damienmaguire/Tesla-Model-3-Charger/DSC_0032_s.jpg

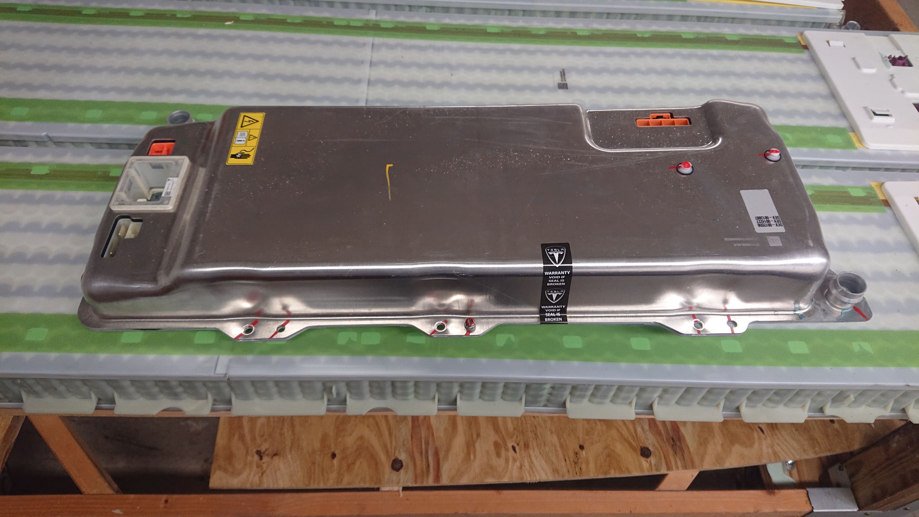
DSC_0032_s.jpg
