damienmaguire/Tesla-Model-3-Charger/Software/stm32-M3-PCS/README.md

# Tesla Model 3 PCS Controller Firmware
02/09/22: V1 of new firmware for STM32 based Tesla Model 3 PCS Controller.

# Compiling
You will need the arm-none-eabi toolchain: https://developer.arm.com/open-source/gnu-toolchain/gnu-rm/downloads
On Ubuntu type

`sudo apt-get install git gcc-arm-none-eabi`

The only external depedencies are libopencm3 and libopeninv. You can download and build these dependencies by typing

`make get-deps`

Now you can compile stm32-<yourname> by typing

`make`

And upload it to your board using a JTAG/SWD adapter, the updater.py script or the esp8266 web interface.
