damienmaguire/Tesla-Model-3-Charger/(threads)

Thread 3 (2023-01-24):

V3 AMPseal 32 way connector locator pins misaligned on the board

joekitch, 2023-01-24:
Documented in this thread on the openinverter forums
https://openinverter.org/forum/viewtopic.php?p=51887#p51887

It looks like the two holes which the ampseal connectors uses to clip onto the board, before soldering, are misaligned. One side seems to be in the correct location but the other is too far out.
