damienmaguire/Tesla-Model-3-Charger/Controller/M3_PCSController_V1 - Schematic.pdf

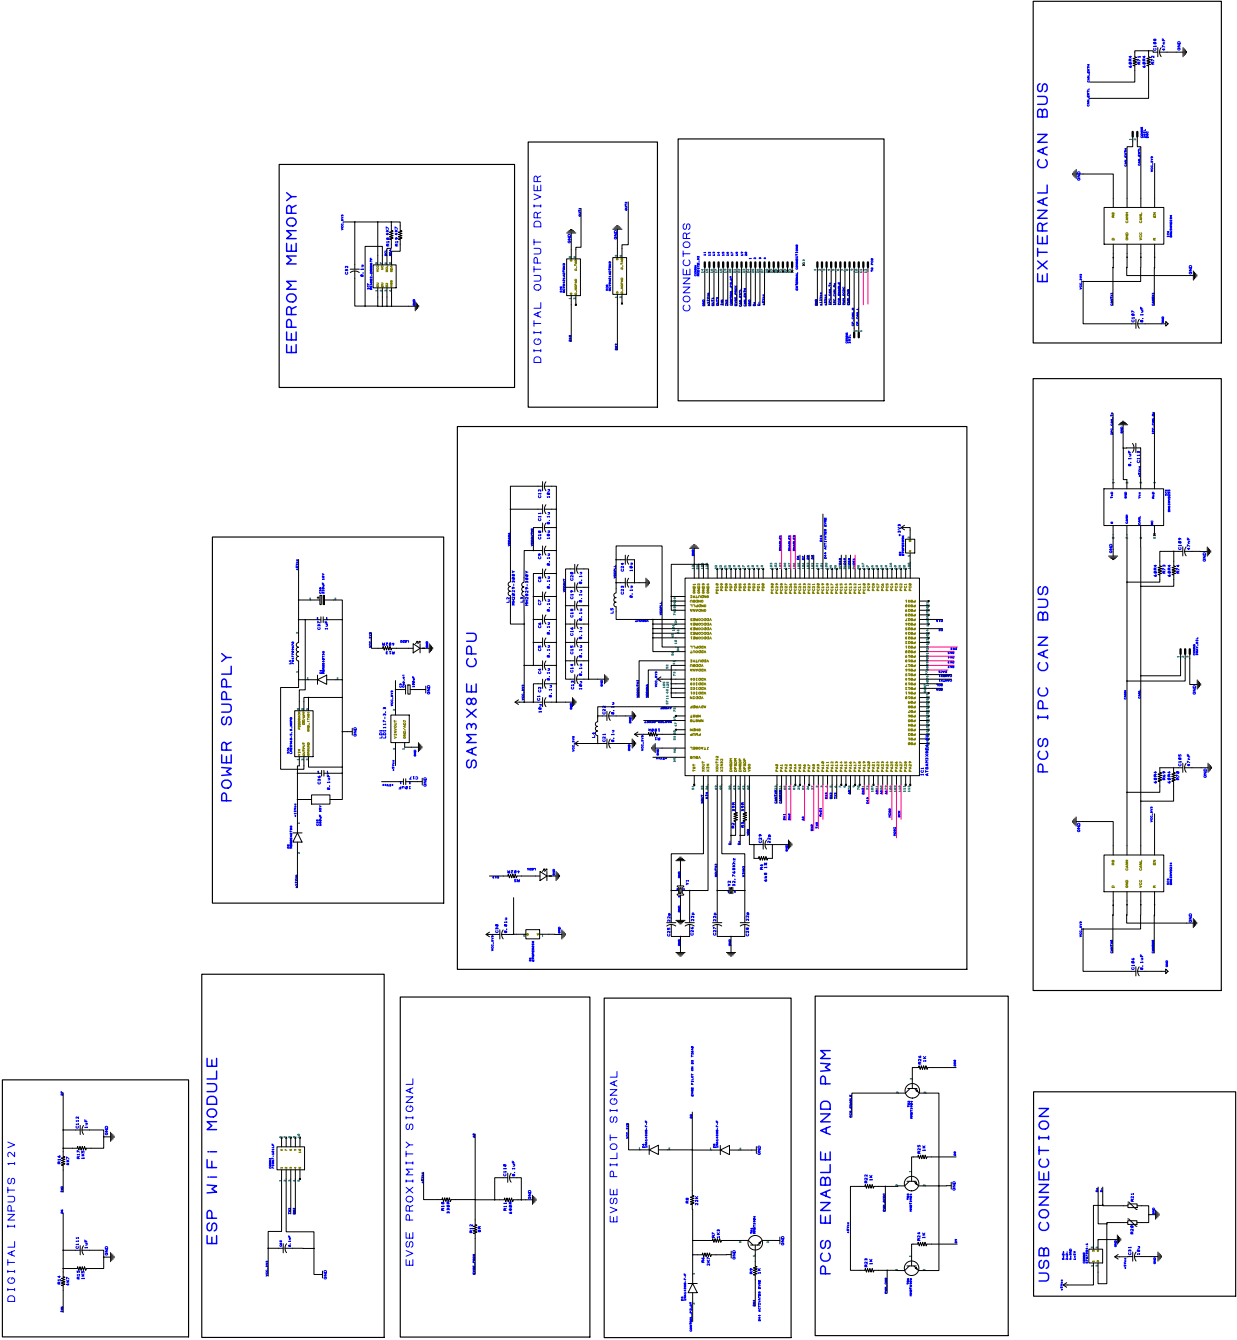
[picture p2: page 1]
