damienmaguire/Tesla-Model-3-Charger/Controller/V3/M3_PCSController_V3 - Schematic.pdf

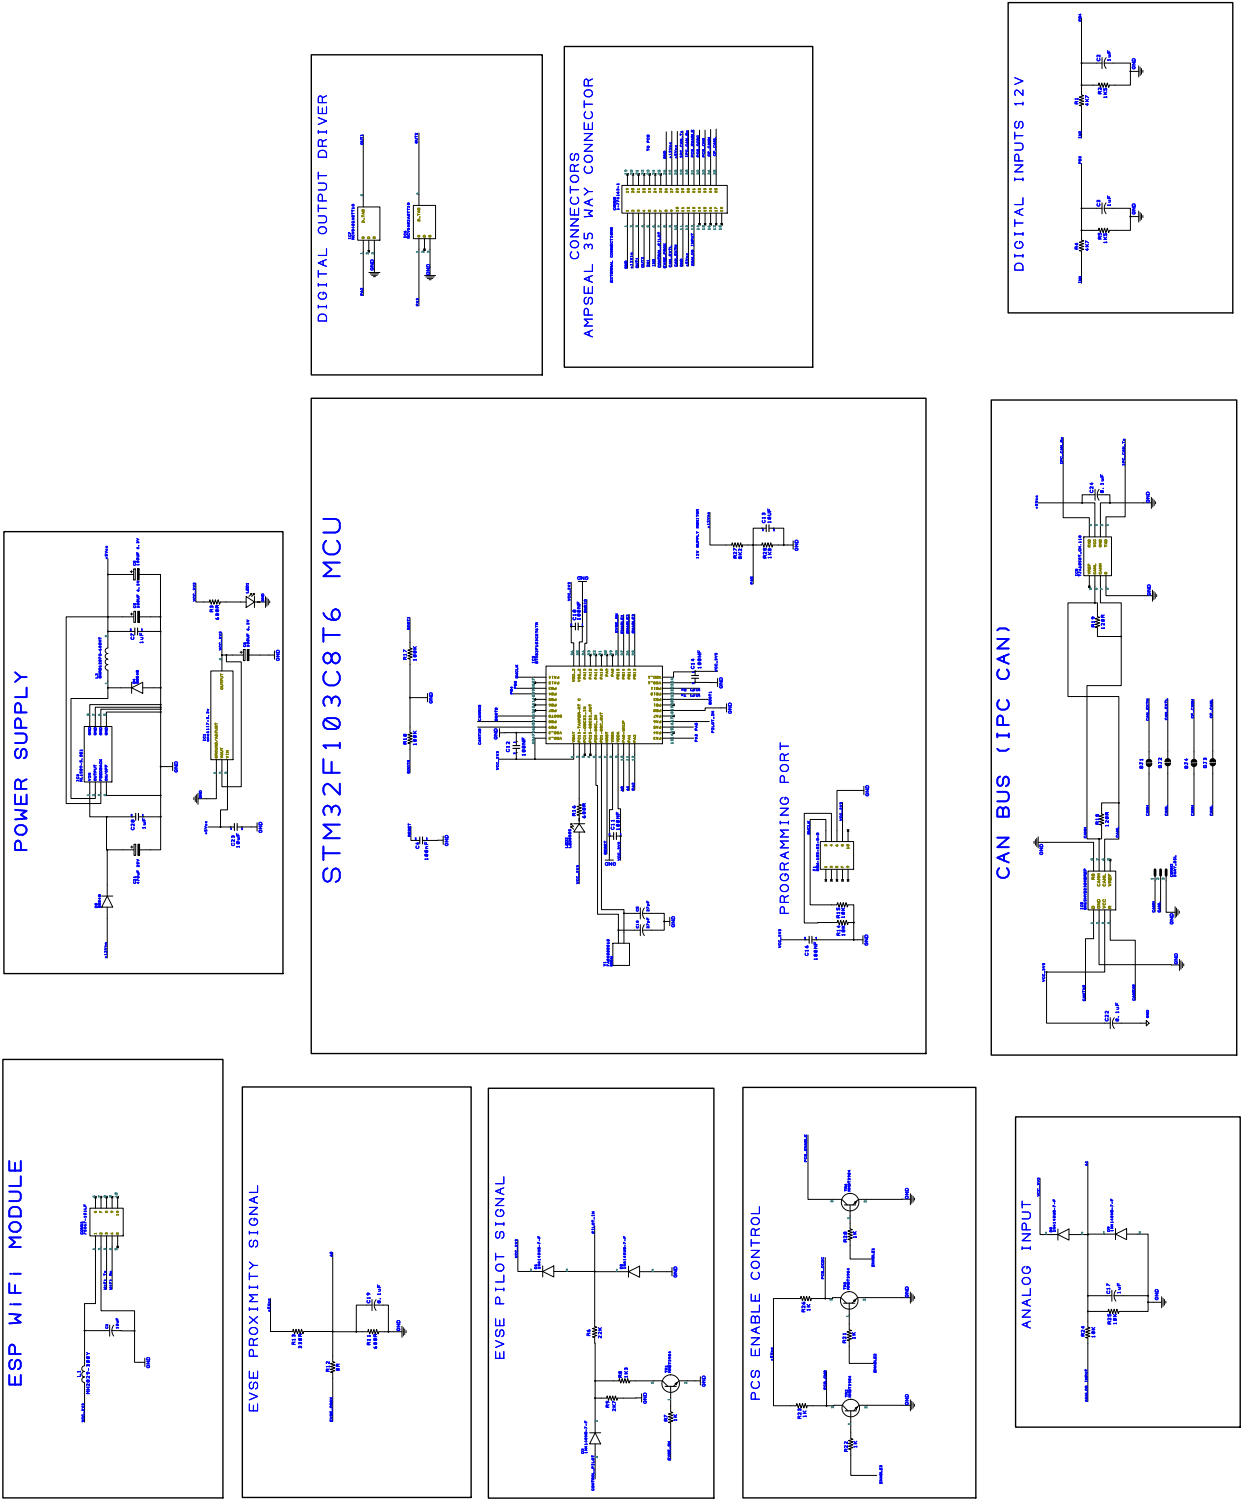
[picture p3: page 1]
