damienmaguire/Tesla-Model-3-Charger/Controller/M3_PCSController_V1 - PCB.pdf

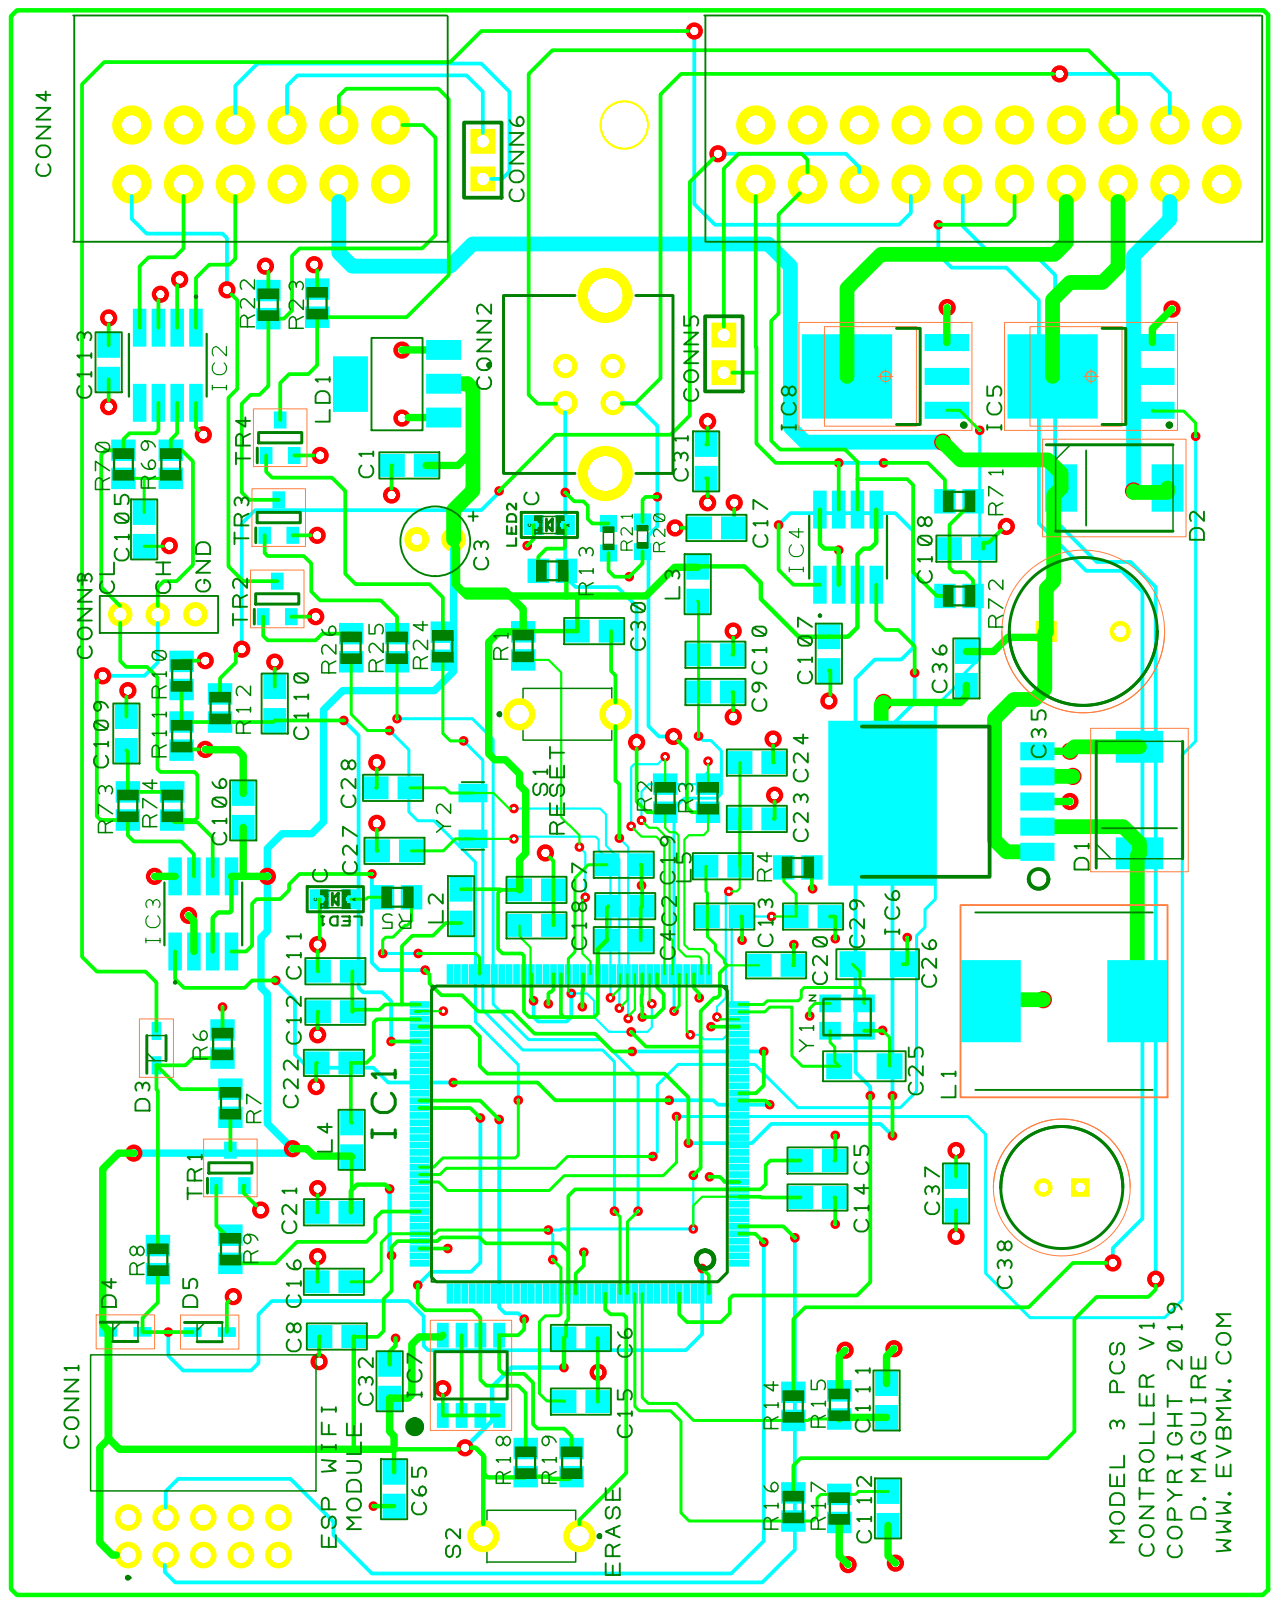
[picture p4: page 1]
