damienmaguire/Tesla-Model-3-Charger/Controller/V3/M3_PCSController_V3 - PCB.pdf

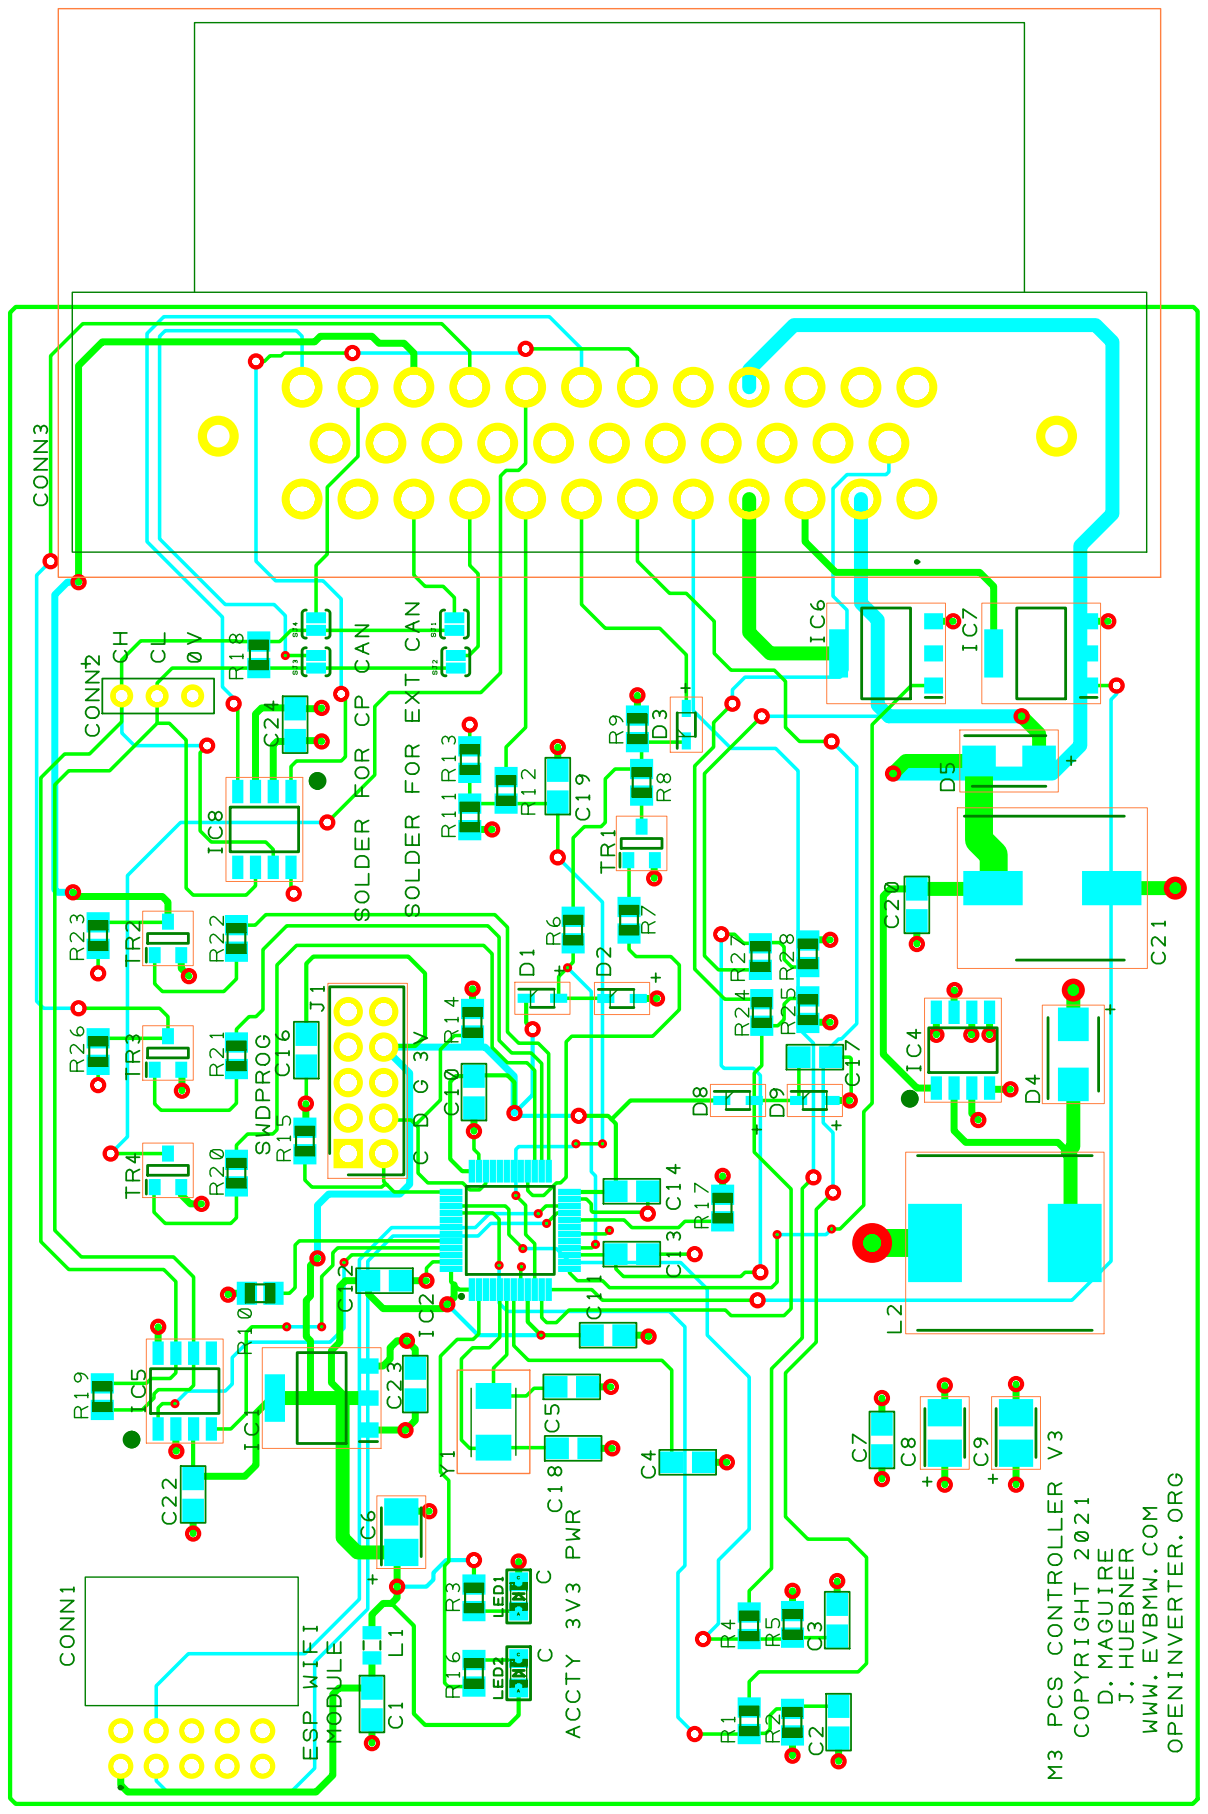
[picture p5: page 1]
