damienmaguire/Tesla-Model-3-Charger/Controller/V2/M3_PCSController_V2 - Schematic.pdf

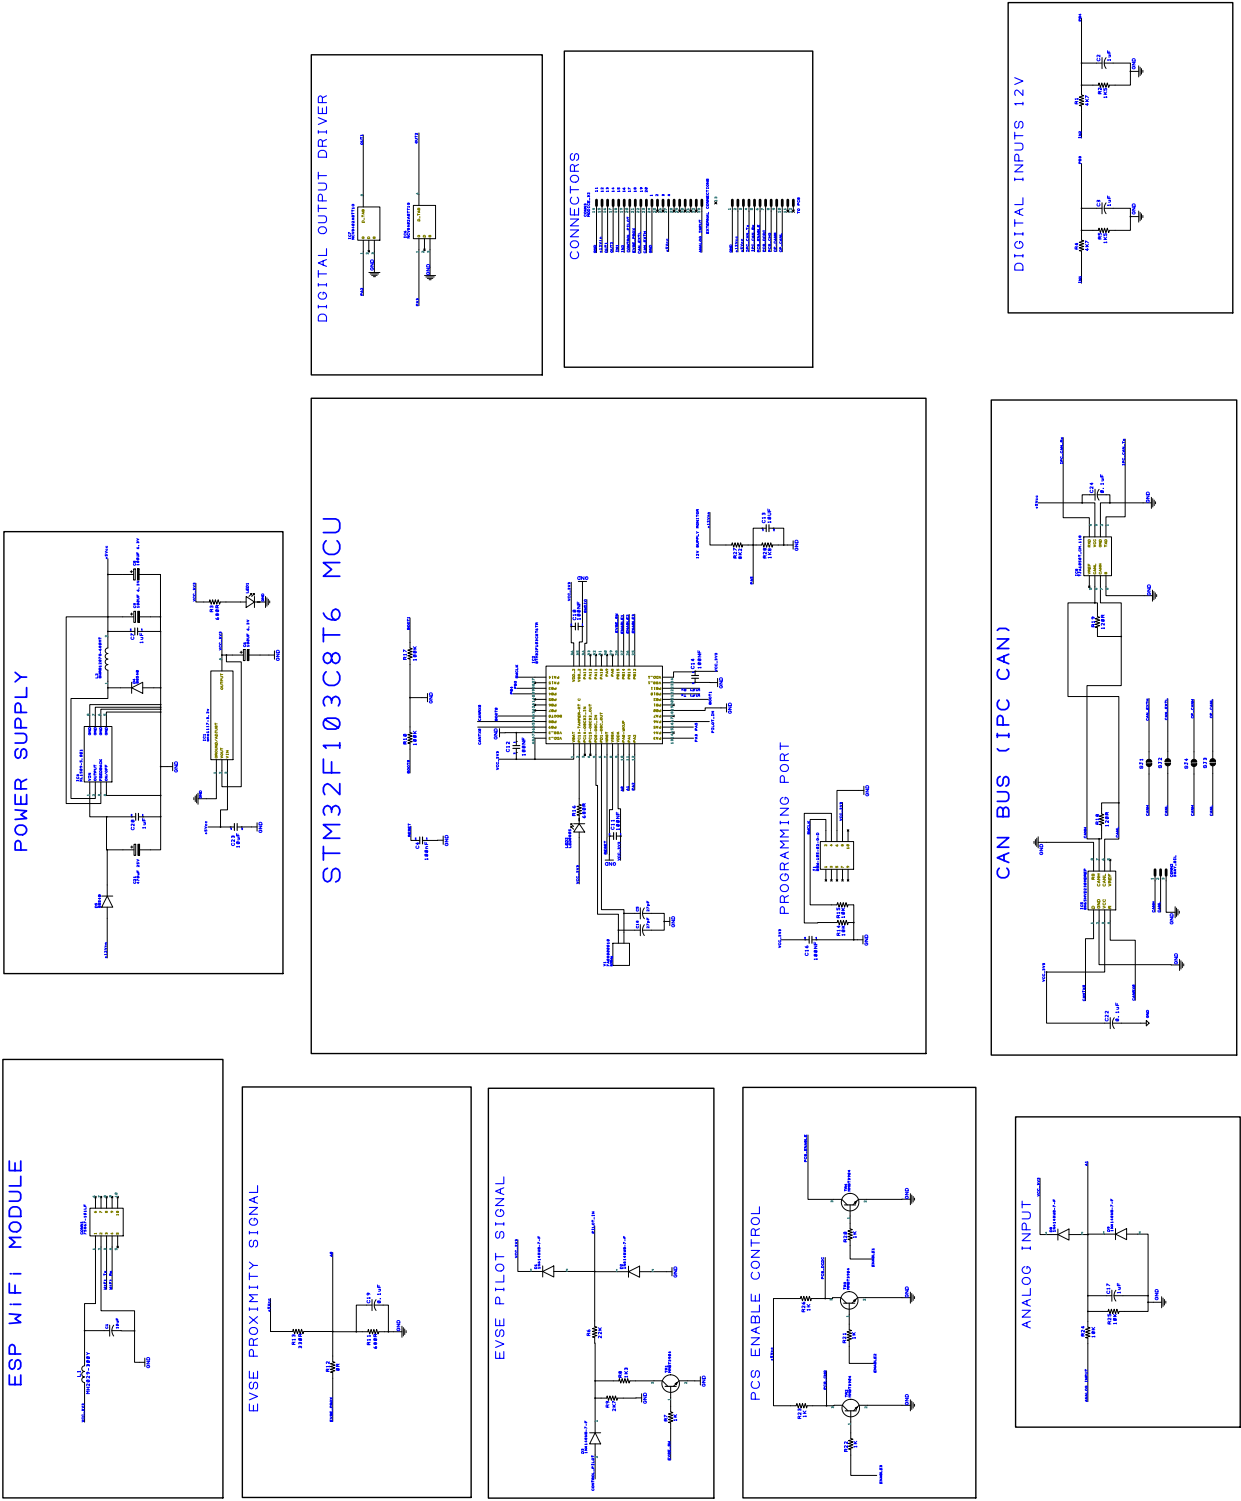
[picture p6: page 1]
