damienmaguire/Tesla-Model-3-Charger/Controller/V2/M3_PCSController_V2 - PCB.pdf

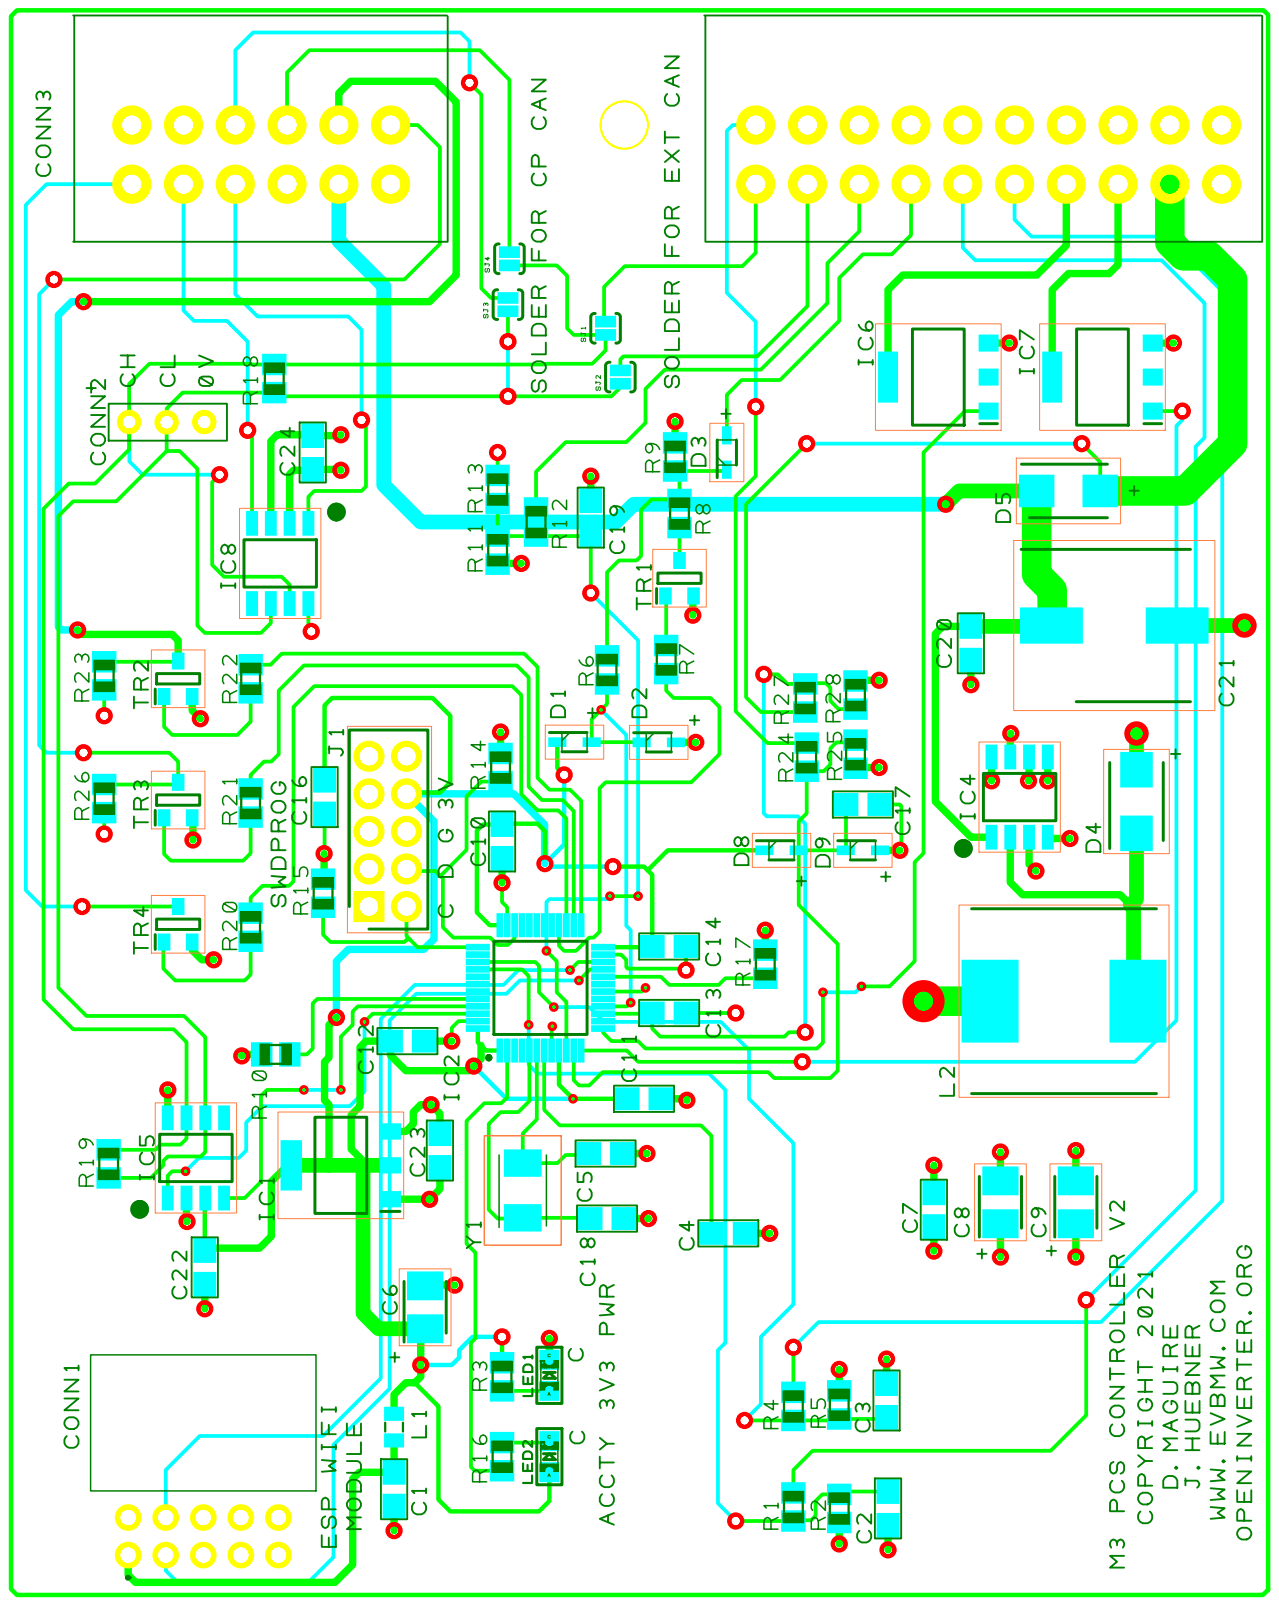
[picture p7: page 1]
