damienmaguire/Tesla-Model-3-Charger/(list of files, drawings)

Other design files:
Controller/M3_PCSController_V1.pcb
