damienmaguire/Tesla-Model-3-Charger/Software/stm32-M3-PCS/src/stm32_can.cpp

/*
 * This file is part of the libopeninv project.
 *
 * Copyright (C) 2016 Nail Güzel
 * Johannes Huebner <dev@johanneshuebner.com>
 *
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
 * You should have received a copy of the GNU General Public License
 * along with this program.  If not, see <http://www.gnu.org/licenses/>.
 */
#include <stdint.h>
#include "hwdefs.h"
#include "my_string.h"
#include "my_math.h"
#include "printf.h"
#include <libopencm3/stm32/can.h>
#include <libopencm3/stm32/gpio.h>
#include <libopencm3/stm32/rcc.h>
#include <libopencm3/stm32/flash.h>
#include <libopencm3/stm32/crc.h>
#include <libopencm3/stm32/rtc.h>
#include <libopencm3/stm32/desig.h>
#include <libopencm3/cm3/common.h>
#include <libopencm3/cm3/nvic.h>
#include "stm32_can.h"

#define MAX_INTERFACES        2
#define IDS_PER_BANK          4
#define EXT_IDS_PER_BANK      2
#define SDO_WRITE             0x40
#define SDO_READ              0x22
#define SDO_ABORT             0x80
#define SDO_WRITE_REPLY       0x23
#define SDO_READ_REPLY        0x43
#define SDO_ERR_INVIDX        0x06020000
#define SDO_ERR_RANGE         0x06090030
#define SENDMAP_ADDRESS(b)    b
#define RECVMAP_ADDRESS(b)    (b + sizeof(canSendMap))
#define POSMAP_ADDRESS(b)     (b + sizeof(canSendMap) + sizeof(canRecvMap))
#define CRC_ADDRESS(b)        (b + sizeof(canSendMap) + sizeof(canRecvMap) + sizeof(canPosMap))
#define SENDMAP_WORDS         (sizeof(canSendMap) / (sizeof(uint32_t)))
#define RECVMAP_WORDS         (sizeof(canRecvMap) / (sizeof(uint32_t)))
#define POSMAP_WORDS          ((sizeof(CANPOS) * MAX_ITEMS) / (sizeof(uint32_t)))
#define ITEM_UNSET            0xff
#define forEachCanMap(c,m) for (CANIDMAP *c = m; (c - m) < MAX_MESSAGES && c->first != MAX_ITEMS; c++)
#define forEachPosMap(c,m) for (CANPOS *c = &canPosMap[m->first]; c->next != ITEM_UNSET; c = &canPosMap[c->next])

#ifdef CAN_EXT
#define IDMAPSIZE 8
#else
#define IDMAPSIZE 4
#endif // CAN_EXT
#if (MAX_ITEMS * 12 + 2 * MAX_MESSAGES * IDMAPSIZE + 4) > FLASH_PAGE_SIZE
#error CANMAP will not fit in one flash page
#endif

struct CAN_SDO
{
   uint8_t cmd;
   uint16_t index;
   uint8_t subIndex;
   uint32_t data;
} __attribute__((packed));

struct CANSPEED
{
   uint32_t ts1;
   uint32_t ts2;
   uint32_t prescaler;
};

Can* Can::interfaces[MAX_INTERFACES];
volatile bool Can::isSaving = false;

static void DummyCallback(uint32_t i, uint32_t* d) { i=i; d=d; }
static const CANSPEED canSpeed[Can::BaudLast] =
{
   { CAN_BTR_TS1_9TQ, CAN_BTR_TS2_6TQ, 18}, //125kbps
   { CAN_BTR_TS1_9TQ, CAN_BTR_TS2_6TQ, 9 }, //250kbps
   { CAN_BTR_TS1_4TQ, CAN_BTR_TS2_3TQ, 9 }, //500kbps
   { CAN_BTR_TS1_5TQ, CAN_BTR_TS2_3TQ, 5 }, //800kbps
   { CAN_BTR_TS1_6TQ, CAN_BTR_TS2_5TQ, 3 }, //1000kbps
};

/** \brief Add periodic CAN message
 *
 * \param param Parameter index of parameter to be sent
 * \param canId CAN identifier of generated message
 * \param offset bit offset within the 64 message bits
 * \param length number of bits
 * \param gain Fixed point gain to be multiplied before sending
 * \return success: number of active messages
 * Fault:
 * - CAN_ERR_INVALID_ID ID was > 0x1fffffff
 * - CAN_ERR_INVALID_OFS Offset > 63
 * - CAN_ERR_INVALID_LEN Length > 32
 * - CAN_ERR_MAXMESSAGES Already 10 send messages defined
 * - CAN_ERR_MAXITEMS Already than MAX_ITEMS items total defined
 */
int Can::AddSend(Param::PARAM_NUM param, uint32_t canId, uint8_t offsetBits, uint8_t length, float gain, int8_t offset)
{
   return Add(canSendMap, param, canId, offsetBits, length, gain, offset);
}

int Can::AddSend(Param::PARAM_NUM param, uint32_t canId, uint8_t offsetBits, uint8_t length, float gain)
{
   return Add(canSendMap, param, canId, offsetBits, length, gain, 0);
}

/** \brief Map data from CAN bus to parameter
 *
 * \param param Parameter index of parameter to be received
 * \param canId CAN identifier of consumed message
 * \param offset bit offset within the 64 message bits
 * \param length number of bits
 * \param gain Fixed point gain to be multiplied after receiving
 * \return success: number of active messages
 * Fault:
 * - CAN_ERR_INVALID_ID ID was > 0x1fffffff
 * - CAN_ERR_INVALID_OFS Offset > 63
 * - CAN_ERR_INVALID_LEN Length > 32
 * - CAN_ERR_MAXMESSAGES Already 10 receive messages defined
 * - CAN_ERR_MAXITEMS Already than MAX_ITEMS items total defined
 */
int Can::AddRecv(Param::PARAM_NUM param, uint32_t canId, uint8_t offsetBits, uint8_t length, float gain, int8_t offset)
{
   int res = Add(canRecvMap, param, canId, offsetBits, length, gain, offset);
   ConfigureFilters();
   return res;
}

int Can::AddRecv(Param::PARAM_NUM param, uint32_t canId, uint8_t offsetBits, uint8_t length, float gain)
{
   return Can::AddRecv(param, canId, offsetBits, length, gain, 0);
}

/** \brief Set function to be called for user handled CAN messages
 *
 * \param recv Function pointer to void func(uint32_t, uint32_t[2]) - ID, Data
 */
void Can::SetReceiveCallback(void (*recv)(uint32_t, uint32_t*))
{
   recvCallback = recv;
}

/** \brief Add CAN Id to user message list
 * \post Receive callback will be called when a message with this Id id received
 * \param canId CAN identifier of message to be user handled
 * \return true: success, false: already 10 messages registered
 *
 */
bool Can::RegisterUserMessage(uint32_t canId)
{
   if (nextUserMessageIndex < MAX_USER_MESSAGES)
   {
      userIds[nextUserMessageIndex] = canId;
      nextUserMessageIndex++;
      ConfigureFilters();
      return true;
   }
   return false;
}

/** \brief Remove all CAN Id from user message list
 */
void Can::ClearUserMessages()
{
   nextUserMessageIndex = 0;
   ConfigureFilters();
}

/** \brief Find first occurence of parameter in CAN map and output its mapping info
 *
 * Memory layout: SendMap, RecvMap, PosMap, CRC
 * Send/Recv maps point to items in PosMap. PosMap may point to next item
 *
 * \param[in] param Index of parameter to be looked up
 * \param[out] canId CAN identifier that the parameter is mapped to
 * \param[out] offset bit offset that the parameter is mapped to
 * \param[out] length number of bits that the parameter is mapped to
 * \param[out] gain Parameter gain
 * \param[out] rx true: Parameter is received via CAN, false: sent via CAN
 * \return true: parameter is mapped, false: not mapped
 */
bool Can::FindMap(Param::PARAM_NUM param, uint32_t& canId, uint8_t& offset, uint8_t& length, float& gain, bool& rx)
{
   rx = false;
   bool done = false;

   for (CANIDMAP *map = canSendMap; !done; map = canRecvMap)
   {
      forEachCanMap(curMap, map)
      {
         forEachPosMap(curPos, curMap)
         {
            if (curPos->mapParam == param)
            {
               canId = curMap->canId;
               offset = curPos->offsetBits;
               length = curPos->numBits;
               gain = curPos->gain;
               return true;
            }
         }
      }
      done = rx;
      rx = true;
   }
   return false;
}

/** \brief Save CAN mapping to flash
 */
void Can::Save()
{
   uint32_t crc;
   uint32_t check = 0xFFFFFFFF;
   uint32_t baseAddress = GetFlashAddress();
   uint32_t *checkAddress = (uint32_t*)baseAddress;

   isSaving = true;

   for (int i = 0; i < FLASH_PAGE_SIZE / 4; i++, checkAddress++)
      check &= *checkAddress;

   crc_reset();

   flash_unlock();
   flash_set_ws(2);

   if (check != 0xFFFFFFFF) //Only erase when needed
      flash_erase_page(baseAddress);

   ReplaceParamEnumByUid(canSendMap);
   ReplaceParamEnumByUid(canRecvMap);

   SaveToFlash(SENDMAP_ADDRESS(baseAddress), (uint32_t *)canSendMap, SENDMAP_WORDS);
   crc = SaveToFlash(RECVMAP_ADDRESS(baseAddress), (uint32_t *)canRecvMap, RECVMAP_WORDS);
   crc = SaveToFlash(POSMAP_ADDRESS(baseAddress), (uint32_t *)canPosMap, POSMAP_WORDS);
   SaveToFlash(CRC_ADDRESS(baseAddress), &crc, 1);
   flash_lock();

   ReplaceParamUidByEnum(canSendMap);
   ReplaceParamUidByEnum(canRecvMap);

   isSaving = false;
}

/** \brief Send all defined messages
 */
void Can::SendAll()
{
   forEachCanMap(curMap, canSendMap)
   {
      uint32_t data[2] = { 0 }; //Had an issue with uint64_t, otherwise would have used that

      forEachPosMap(curPos, curMap)
      {
         if (isSaving) return; //Only send mapped messages when not currently saving to flash

         float val = Param::GetFloat((Param::PARAM_NUM)curPos->mapParam);

         val *= curPos->gain;
         val += curPos->offset;
         int ival = val;
         ival &= ((1 << curPos->numBits) - 1);

         if (curPos->offsetBits > 31)
         {
            data[1] |= ival << (curPos->offsetBits - 32);
         }
         else
         {
            data[0] |= ival << curPos->offsetBits;
         }
      }

      Send(curMap->canId, data);
   }
}

/** \brief Clear all defined messages
 */
void Can::Clear()
{
   ClearMap(canSendMap);
   ClearMap(canRecvMap);
   ConfigureFilters();
}

/** \brief Remove all occurences of given parameter from CAN map
 *
 * \param param Parameter index to be removed
 * \return int number of removed items
 *
 */
int Can::Remove(Param::PARAM_NUM param)
{
   int removed = RemoveFromMap(canSendMap, param);
   removed += RemoveFromMap(canRecvMap, param);

   return removed;
}

/** \brief Init can hardware with given baud rate
 * Initializes the following sub systems:
 * - CAN hardware itself
 * - Appropriate GPIO pins
 * - Enables appropriate interrupts in NVIC
 *
 * \param baseAddr base address of CAN peripheral, CAN1 or CAN2
 * \param baudrate enum baudrates
 * \param remap use remapped IO pins
 * \return void
 *
 */
Can::Can(uint32_t baseAddr, enum baudrates baudrate, bool remap)
   : lastRxTimestamp(0), sendCnt(0), recvCallback(DummyCallback), nextUserMessageIndex(0), canDev(baseAddr)
{
   Clear();
   LoadFromFlash();

   switch (baseAddr)
   {
      case CAN1:
         if (remap)
         {
            // Configure CAN pin: RX (input pull-up).
            gpio_set_mode(GPIO_BANK_CAN1_PB_RX, GPIO_MODE_INPUT, GPIO_CNF_INPUT_PULL_UPDOWN, GPIO_CAN1_PB_RX);
            gpio_set(GPIO_BANK_CAN1_PB_RX, GPIO_CAN1_PB_RX);
            // Configure CAN pin: TX.-
            gpio_set_mode(GPIO_BANK_CAN1_PB_TX, GPIO_MODE_OUTPUT_50_MHZ, GPIO_CNF_OUTPUT_ALTFN_PUSHPULL, GPIO_CAN1_PB_TX);
         }
         else
         {
            // Configure CAN pin: RX (input pull-up).
            gpio_set_mode(GPIO_BANK_CAN1_RX, GPIO_MODE_INPUT, GPIO_CNF_INPUT_PULL_UPDOWN, GPIO_CAN1_RX);
            gpio_set(GPIO_BANK_CAN1_RX, GPIO_CAN1_RX);
            // Configure CAN pin: TX.-
            gpio_set_mode(GPIO_BANK_CAN1_TX, GPIO_MODE_OUTPUT_50_MHZ, GPIO_CNF_OUTPUT_ALTFN_PUSHPULL, GPIO_CAN1_TX);
         }

         //CAN1 RX and TX IRQs
         nvic_enable_irq(NVIC_USB_LP_CAN_RX0_IRQ); //CAN RX
         nvic_set_priority(NVIC_USB_LP_CAN_RX0_IRQ, 0xf << 4); //lowest priority
         nvic_enable_irq(NVIC_CAN_RX1_IRQ); //CAN RX
         nvic_set_priority(NVIC_CAN_RX1_IRQ, 0xf << 4); //lowest priority
         nvic_enable_irq(NVIC_USB_HP_CAN_TX_IRQ); //CAN TX
         nvic_set_priority(NVIC_USB_HP_CAN_TX_IRQ, 0xf << 4); //lowest priority
         interfaces[0] = this;
         break;
      case CAN2:
         if (remap)
         {
            // Configure CAN pin: RX (input pull-up).
            gpio_set_mode(GPIO_BANK_CAN2_RE_RX, GPIO_MODE_INPUT, GPIO_CNF_INPUT_PULL_UPDOWN, GPIO_CAN2_RE_RX);
            gpio_set(GPIO_BANK_CAN2_RE_RX, GPIO_CAN2_RE_RX);
            // Configure CAN pin: TX.-
            gpio_set_mode(GPIO_BANK_CAN2_RE_TX, GPIO_MODE_OUTPUT_50_MHZ, GPIO_CNF_OUTPUT_ALTFN_PUSHPULL, GPIO_CAN2_RE_TX);
         }
         else
         {
            // Configure CAN pin: RX (input pull-up).
            gpio_set_mode(GPIO_BANK_CAN2_RX, GPIO_MODE_INPUT, GPIO_CNF_INPUT_PULL_UPDOWN, GPIO_CAN2_RX);
            gpio_set(GPIO_BANK_CAN2_RX, GPIO_CAN2_RX);
            // Configure CAN pin: TX.-
            gpio_set_mode(GPIO_BANK_CAN2_TX, GPIO_MODE_OUTPUT_50_MHZ, GPIO_CNF_OUTPUT_ALTFN_PUSHPULL, GPIO_CAN2_TX);
         }

         //CAN2 RX and TX IRQs
         nvic_enable_irq(NVIC_CAN2_RX0_IRQ); //CAN RX
         nvic_set_priority(NVIC_CAN2_RX0_IRQ, 0xf << 4); //lowest priority
         nvic_enable_irq(NVIC_CAN2_RX1_IRQ); //CAN RX
         nvic_set_priority(NVIC_CAN2_RX1_IRQ, 0xf << 4); //lowest priority
         nvic_enable_irq(NVIC_CAN2_TX_IRQ); //CAN RX
         nvic_set_priority(NVIC_CAN2_TX_IRQ, 0xf << 4); //lowest priority
         interfaces[1] = this;
         break;
   }

   nodeId = 1;
	// Reset CAN
	can_reset(canDev);

	SetBaudrate(baudrate);
   ConfigureFilters();
	// Enable CAN RX interrupts.
	can_enable_irq(canDev, CAN_IER_FMPIE0);
	can_enable_irq(canDev, CAN_IER_FMPIE1);
}

/** \brief Set baud rate to given value
 *
 * \param baudrate enum baudrates
 * \return void
 *
 */
void Can::SetBaudrate(enum baudrates baudrate)
{
	// CAN cell init.
	 // Setting the bitrate to 250KBit. APB1 = 36MHz,
	 // prescaler = 9 -> 4MHz time quanta frequency.
	 // 1tq sync + 9tq bit segment1 (TS1) + 6tq bit segment2 (TS2) =
	 // 16time quanto per bit period, therefor 4MHz/16 = 250kHz
	 //
	can_init(canDev,
		     false,          // TTCM: Time triggered comm mode?
		     true,           // ABOM: Automatic bus-off management?
		     false,          // AWUM: Automatic wakeup mode?
		     false,          // NART: No automatic retransmission?
		     false,          // RFLM: Receive FIFO locked mode?
		     false,          // TXFP: Transmit FIFO priority?
		     CAN_BTR_SJW_1TQ,
		     canSpeed[baudrate].ts1,
		     canSpeed[baudrate].ts2,
		     canSpeed[baudrate].prescaler,				// BRP+1: Baud rate prescaler
		     false,
		     false);
}

/** \brief Get RTC time when last message was received
 *
 * \return uint32_t RTC time
 *
 */
uint32_t Can::GetLastRxTimestamp()
{
   return lastRxTimestamp;
}

/** \brief Send a user defined CAN message
 *
 * \param canId uint32_t
 * \param data[2] uint32_t
 * \param len message length
 * \return void
 *
 */
void Can::Send(uint32_t canId, uint32_t data[2], uint8_t len)
{
   can_disable_irq(canDev, CAN_IER_TMEIE);

   if (can_transmit(canDev, canId, canId > 0x7FF, false, len, (uint8_t*)data) < 0 && sendCnt < SENDBUFFER_LEN)
   {
      /* enqueue in send buffer if all TX mailboxes are full */
      sendBuffer[sendCnt].id = canId;
      sendBuffer[sendCnt].len = len;
      sendBuffer[sendCnt].data[0] = data[0];
      sendBuffer[sendCnt].data[1] = data[1];
      sendCnt++;
   }

   if (sendCnt > 0)
   {
      can_enable_irq(canDev, CAN_IER_TMEIE);
   }
}

void Can::IterateCanMap(void (*callback)(Param::PARAM_NUM, uint32_t, uint8_t, uint8_t, float, bool))
{
   bool done = false, rx = false;

   for (CANIDMAP *map = canSendMap; !done; map = canRecvMap)
   {
      forEachCanMap(curMap, map)
      {
         forEachPosMap(curPos, curMap)
         {
            callback((Param::PARAM_NUM)curPos->mapParam, curMap->canId, curPos->offsetBits, curPos->numBits, curPos->gain, rx);
         }
      }
      done = rx;
      rx = true;
   }
}

Can* Can::GetInterface(int index)
{
   if (index < MAX_INTERFACES)
   {
      return interfaces[index];
   }
   return 0;
}

void Can::HandleRx(int fifo)
{
   uint32_t id;
	bool ext, rtr;
	uint8_t length, fmi;
	uint32_t data[2];

   while (can_receive(canDev, fifo, true, &id, &ext, &rtr, &fmi, &length, (uint8_t*)data, NULL) > 0)
   {
      //printf("fifo: %d, id: %x, len: %d, data[0]: %x, data[1]: %x\r\n", fifo, id, length, data[0], data[1]);
      if (id == (0x600U + nodeId) && length == 8) //SDO request
      {
         ProcessSDO(data);
      }
      else
      {
         if (isSaving) continue; //Only handle mapped messages when not currently saving to flash

         CANIDMAP *recvMap = FindById(canRecvMap, id);

         if (0 != recvMap)
         {
            forEachPosMap(curPos, recvMap)
            {
               float val;

               if (curPos->offsetBits > 31)
               {
                  val = (data[1] >> (curPos->offsetBits - 32)) & ((1 << curPos->numBits) - 1);
               }
               else
               {
                  val = (data[0] >> curPos->offsetBits) & ((1 << curPos->numBits) - 1);
               }
               val += curPos->offset;
               val *= curPos->gain;

               if (Param::IsParam((Param::PARAM_NUM)curPos->mapParam))
                  Param::Set((Param::PARAM_NUM)curPos->mapParam, FP_FROMFLT(val));
               else
                  Param::SetFloat((Param::PARAM_NUM)curPos->mapParam, val);
            }
            lastRxTimestamp = rtc_get_counter_val();
         }
         else //Now it must be a user message, as filters block everything else
         {
            recvCallback(id, data);
         }
      }
   }
}

void Can::HandleTx()
{
   SENDBUFFER* b = sendBuffer; //alias

   while (sendCnt > 0 && can_transmit(canDev, b[sendCnt - 1].id, b[sendCnt - 1].id > 0x7FF, false, b[sendCnt - 1].len, (uint8_t*)b[sendCnt - 1].data) >= 0)
      sendCnt--;

   if (sendCnt == 0)
   {
      can_disable_irq(canDev, CAN_IER_TMEIE);
   }
}

void Can::SDOWrite(uint8_t remoteNodeId, uint16_t index, uint8_t subIndex, uint32_t data)
{
   uint32_t d[2];
   CAN_SDO *sdo = (CAN_SDO*)d;

   sdo->cmd = SDO_WRITE;
   sdo->index = index;
   sdo->subIndex = subIndex;
   sdo->data = data;

   Send(0x600 + remoteNodeId, d);
}

/****************** Private methods and ISRs ********************/

//http://www.byteme.org.uk/canopenparent/canopen/sdo-service-data-objects-canopen/
void Can::ProcessSDO(uint32_t data[2])
{
   CAN_SDO *sdo = (CAN_SDO*)data;
   if (sdo->index >= 0x2000 && sdo->index <= 0x2001 && sdo->subIndex < Param::PARAM_LAST)
   {
      Param::PARAM_NUM paramIdx = (Param::PARAM_NUM)sdo->subIndex;

      //SDO index 0x2001 will lookup the parameter by its unique ID
      if (sdo->index == 0x2001)
         paramIdx = Param::NumFromId(sdo->subIndex);

      if (sdo->cmd == SDO_WRITE)
      {
         if (Param::Set(paramIdx, sdo->data) == 0)
         {
            sdo->cmd = SDO_WRITE_REPLY;
         }
         else
         {
            sdo->cmd = SDO_ABORT;
            sdo->data = SDO_ERR_RANGE;
         }
      }
      else if (sdo->cmd == SDO_READ)
      {
         sdo->data = Param::Get(paramIdx);
         sdo->cmd = SDO_READ_REPLY;
      }
   }
   else if (sdo->index >= 0x3000 && sdo->index < 0x4800 && sdo->subIndex < Param::PARAM_LAST)
   {
      if (sdo->cmd == SDO_WRITE)
      {
         int result;
         int offset = sdo->data & 0xFF;
         int len = (sdo->data >> 8) & 0xFF;
         s32fp gain = sdo->data >> 16;

         if ((sdo->index & 0x4000) == 0x4000)
         {
            result = Can::AddRecv((Param::PARAM_NUM)sdo->subIndex, sdo->index & 0x7FF, offset, len, gain);
         }
         else
         {
            result = Can::AddSend((Param::PARAM_NUM)sdo->subIndex, sdo->index & 0x7FF, offset, len, gain);
         }

         if (result >= 0)
         {
            sdo->cmd = SDO_WRITE_REPLY;
         }
         else
         {
            sdo->cmd = SDO_ABORT;
            sdo->data = SDO_ERR_RANGE;
         }
      }
   }
   else
   {
      sdo->cmd = SDO_ABORT;
      sdo->data = SDO_ERR_INVIDX;
   }
   Can::Send(0x580 + nodeId, data);
}

void Can::SetFilterBank(int& idIndex, int& filterId, uint16_t* idList)
{
   can_filter_id_list_16bit_init(
         filterId,
         idList[0] << 5, //left align
         idList[1] << 5,
         idList[2] << 5,
         idList[3] << 5,
         filterId & 1,
         true);
   idIndex = 0;
   filterId++;
   idList[0] = idList[1] = idList[2] = idList[3] = 0;
}

void Can::SetFilterBank29(int& idIndex, int& filterId, uint32_t* idList)
{
   can_filter_id_list_32bit_init(
         filterId,
         (idList[0] << 3) | 0x4, //filter extended
         (idList[1] << 3) | 0x4,
         filterId & 1,
         true);
   idIndex = 0;
   filterId++;
   idList[0] = idList[1] = 0;
}

void Can::ConfigureFilters()
{
   uint16_t idList[IDS_PER_BANK] = { 0, 0, 0, 0 };
   uint32_t extIdList[EXT_IDS_PER_BANK] = { 0, 0 };
   int idIndex = 1, extIdIndex = 0;
   int filterId = canDev == CAN1 ? 0 : ((CAN_FMR(CAN2) >> 8) & 0x3F);

   for (int i = 0; i < nextUserMessageIndex; i++)
   {
      if (userIds[i] > 0x7ff)
      {
         extIdList[extIdIndex] = userIds[i];
         extIdIndex++;
      }
      else
      {
         idList[idIndex] = userIds[i];
         idIndex++;
      }

      if (idIndex == IDS_PER_BANK)
      {
         SetFilterBank(idIndex, filterId, idList);
      }
      if (extIdIndex == EXT_IDS_PER_BANK)
      {
         SetFilterBank29(extIdIndex, filterId, extIdList);
      }
   }

   forEachCanMap(curMap, canRecvMap)
   {
      if (curMap->canId > 0x7ff)
      {
         extIdList[extIdIndex] = curMap->canId;
         extIdIndex++;
      }
      else
      {
         idList[idIndex] = curMap->canId;
         idIndex++;
      }

      if (idIndex == IDS_PER_BANK)
      {
         SetFilterBank(idIndex, filterId, idList);
      }
      if (extIdIndex == EXT_IDS_PER_BANK)
      {
         SetFilterBank29(extIdIndex, filterId, extIdList);
      }
   }

   //loop terminates before adding last set of filters
   if (idIndex > 0)
   {
      SetFilterBank(idIndex, filterId, idList);
   }
   if (extIdIndex > 0)
   {
      SetFilterBank29(extIdIndex, filterId, extIdList);
   }
}

int Can::LoadFromFlash()
{
   uint32_t baseAddress = GetFlashAddress();
   uint32_t storedCrc = *(uint32_t*)CRC_ADDRESS(baseAddress);
   uint32_t crc;

   crc_reset();
   crc = crc_calculate_block((uint32_t*)baseAddress, SENDMAP_WORDS + RECVMAP_WORDS + POSMAP_WORDS);

   if (storedCrc == crc)
   {
      memcpy32((int*)canSendMap, (int*)SENDMAP_ADDRESS(baseAddress), SENDMAP_WORDS);
      memcpy32((int*)canRecvMap, (int*)RECVMAP_ADDRESS(baseAddress), RECVMAP_WORDS);
      memcpy32((int*)canPosMap, (int*)POSMAP_ADDRESS(baseAddress), POSMAP_WORDS);
      ReplaceParamUidByEnum(canSendMap);
      ReplaceParamUidByEnum(canRecvMap);
      return 1;
   }
   return 0;
}

int Can::RemoveFromMap(CANIDMAP *canMap, Param::PARAM_NUM param)
{
   int removed = 0;
   CANPOS *lastPosMap;

   forEachCanMap(curMap, canMap)
   {
      lastPosMap = 0;

      forEachPosMap(curPos, curMap)
      {
         if (curPos->mapParam == param)
         {
            if (lastPosMap != 0)
            {
               lastPosMap->next = curPos->next;
            }
            else
            {
               curMap->first = curPos->next;
            }
         }
         lastPosMap = curPos;
      }
   }

   return removed;
}

int Can::Add(CANIDMAP *canMap, Param::PARAM_NUM param, uint32_t canId, uint8_t offsetBits, uint8_t length, float gain, int8_t offset)
{
   if (canId > 0x1fffffff) return CAN_ERR_INVALID_ID;
   if (offsetBits > 63) return CAN_ERR_INVALID_OFS;
   if (length > 32) return CAN_ERR_INVALID_LEN;

   CANIDMAP *existingMap = FindById(canMap, canId);

   if (0 == existingMap)
   {
      for (int i = 0; i < MAX_MESSAGES; i++)
      {
         if (canMap[i].first == MAX_ITEMS)
         {
            existingMap = &canMap[i];
            break;
         }
      }

      if (0 == existingMap)
         return CAN_ERR_MAXMESSAGES;

      existingMap->canId = canId;
   }

   int freeIndex;

   for (freeIndex = 0; freeIndex < MAX_ITEMS && canPosMap[freeIndex].next != ITEM_UNSET; freeIndex++);

   if (freeIndex == MAX_ITEMS)
      return CAN_ERR_MAXITEMS;

   CANPOS* precedingItem = 0;

   for (int precedingIndex = existingMap->first; precedingIndex != MAX_ITEMS; precedingIndex = canPosMap[precedingIndex].next)
      precedingItem = &canPosMap[precedingIndex];

   CANPOS* freeItem = &canPosMap[freeIndex];
   freeItem->mapParam = param;
   freeItem->gain = gain;
   freeItem->offset = offset;
   freeItem->offsetBits = offsetBits;
   freeItem->numBits = length;
   freeItem->next = MAX_ITEMS;

   if (precedingItem == 0) //first item for this can ID
   {
      existingMap->first = freeIndex;
   }
   else
   {
      precedingItem->next = freeIndex;
   }

   int count = 0;

   forEachCanMap(curMap, canMap)
      count++;

   return count;
}

void Can::ClearMap(CANIDMAP *canMap)
{
   for (int i = 0; i < MAX_MESSAGES; i++)
   {
      canMap[i].first = MAX_ITEMS;
   }

   //Initialize also tail to ITEM_UNSET
   for (int i = 0; i < (MAX_ITEMS + 1); i++)
   {
      canPosMap[i].next = ITEM_UNSET;
   }
}

Can::CANIDMAP* Can::FindById(CANIDMAP *canMap, uint32_t canId)
{
   forEachCanMap(curMap, canMap)
   {
      if (curMap->canId == canId)
         return curMap;
   }
   return 0;
}

uint32_t Can::SaveToFlash(uint32_t baseAddress, uint32_t* data, int len)
{
   uint32_t crc = 0;

   for (int idx = 0; idx < len; idx++)
   {
      crc = crc_calculate(*data);
      flash_program_word(baseAddress + idx * sizeof(uint32_t), *data);
      data++;
   }

   return crc;
}

int Can::CopyIdMapExcept(CANIDMAP *source, CANIDMAP *dest, Param::PARAM_NUM param)
{
   int i = 0, removed = 0;
   int j = 0;

   forEachCanMap(curMap, source)
   {
      bool discardId = true;

      forEachPosMap(curPos, curMap)
      {
         if (curPos->mapParam != param)
         {
            discardId = false;
            canPosMap[j] = *curPos;
            j++;
         }
         else
         {
            removed++;
         }
      }

      if (!discardId)
      {
         dest[i].canId = curMap->canId;
         i++;
      }
   }

   return removed;
}

void Can::ReplaceParamEnumByUid(CANIDMAP *canMap)
{
   forEachCanMap(curMap, canMap)
   {
      forEachPosMap(curPos, curMap)
      {
         const Param::Attributes* attr = Param::GetAttrib((Param::PARAM_NUM)curPos->mapParam);
         curPos->mapParam = (uint16_t)attr->id;
      }
   }
}

void Can::ReplaceParamUidByEnum(CANIDMAP *canMap)
{
   forEachCanMap(curMap, canMap)
   {
      forEachPosMap(curPos, curMap)
      {
         Param::PARAM_NUM param = Param::NumFromId(curPos->mapParam);
         curPos->mapParam = param;
      }
   }
}

uint32_t Can::GetFlashAddress()
{
   uint32_t flashSize = desig_get_flash_size();

   //Always save CAN mapping to second-to-last flash page
   return FLASH_BASE + flashSize * 1024 - FLASH_PAGE_SIZE * (canDev == CAN1 ? CAN1_BLKNUM : CAN2_BLKNUM);
}

/* Interrupt service routines */
extern "C" void usb_lp_can_rx0_isr(void)
{
   Can::GetInterface(0)->HandleRx(0);
}

extern "C" void can_rx1_isr()
{
   Can::GetInterface(0)->HandleRx(1);
}

extern "C" void usb_hp_can_tx_isr()
{
   Can::GetInterface(0)->HandleTx();
}

extern "C" void can2_rx0_isr()
{
   Can::GetInterface(1)->HandleRx(0);
}

extern "C" void can2_rx1_isr()
{
   Can::GetInterface(1)->HandleRx(1);
}

extern "C" void can2_tx_isr()
{
   Can::GetInterface(1)->HandleTx();
}
