damienmaguire/Tesla-Model-3-Charger/Software/stm32-M3-PCS/src/terminal.cpp

/*
 * This file is part of the libopeninv project.
 *
 * Copyright (C) 2011 Johannes Huebner <dev@johanneshuebner.com>
 *
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
 * You should have received a copy of the GNU General Public License
 * along with this program.  If not, see <http://www.gnu.org/licenses/>.
 */

#include "my_string.h"
#include <libopencm3/cm3/common.h>
#include <libopencm3/stm32/usart.h>
#include <libopencm3/stm32/gpio.h>
#include <libopencm3/stm32/dma.h>
#include "terminal.h"
#include "printf.h"

#define HWINFO_ENTRIES (sizeof(hwInfo) / sizeof(struct HwInfo))

#ifndef USART_BAUDRATE
#define USART_BAUDRATE 115200
#endif // USART_BAUDRATE

const Terminal::HwInfo Terminal::hwInfo[] =
{
   { USART1, DMA_CHANNEL4, DMA_CHANNEL5, GPIOA, GPIO_USART1_TX, GPIOB, GPIO_USART1_RE_TX },
   { USART2, DMA_CHANNEL7, DMA_CHANNEL6, GPIOA, GPIO_USART2_TX, GPIOD, GPIO_USART2_RE_TX },
   { USART3, DMA_CHANNEL2, DMA_CHANNEL3, GPIOB, GPIO_USART3_TX, GPIOC, GPIO_USART3_PR_TX },
};

Terminal* Terminal::defaultTerminal;

Terminal::Terminal(uint32_t usart, const TERM_CMD* commands, bool remap)
:  usart(usart),
   remap(remap),
   termCmds(commands),
   nodeId(1),
   enabled(true),
   txDmaEnabled(true),
   pCurCmd(NULL),
   lastIdx(0),
   curBuf(0),
   curIdx(0),
   firstSend(true)
{
   //Search info entry
   hw = hwInfo;
   for (uint32_t i = 0; i < HWINFO_ENTRIES; i++)
   {
      if (hw->usart == usart) break;
      hw++;
   }

   defaultTerminal = this;

   gpio_set_mode(remap ? hw->port_re : hw->port, GPIO_MODE_OUTPUT_50_MHZ,
               GPIO_CNF_OUTPUT_ALTFN_PUSHPULL, remap ? hw->pin_re : hw->pin);

   usart_set_baudrate(usart, USART_BAUDRATE);
   usart_set_databits(usart, 8);
   usart_set_stopbits(usart, USART_STOPBITS_2);
   usart_set_mode(usart, USART_MODE_TX_RX);
   usart_set_parity(usart, USART_PARITY_NONE);
   usart_set_flow_control(usart, USART_FLOWCONTROL_NONE);
   usart_enable_rx_dma(usart);
   usart_enable_tx_dma(usart);

   dma_channel_reset(DMA1, hw->dmatx);
   dma_set_read_from_memory(DMA1, hw->dmatx);
   dma_set_peripheral_address(DMA1, hw->dmatx, (uint32_t)&USART_DR(usart));
   dma_set_peripheral_size(DMA1, hw->dmatx, DMA_CCR_PSIZE_8BIT);
   dma_set_memory_size(DMA1, hw->dmatx, DMA_CCR_MSIZE_8BIT);
   dma_enable_memory_increment_mode(DMA1, hw->dmatx);

   dma_channel_reset(DMA1, hw->dmarx);
   dma_set_peripheral_address(DMA1, hw->dmarx, (uint32_t)&USART_DR(usart));
   dma_set_peripheral_size(DMA1, hw->dmarx, DMA_CCR_PSIZE_8BIT);
   dma_set_memory_size(DMA1, hw->dmarx, DMA_CCR_MSIZE_8BIT);
   dma_enable_memory_increment_mode(DMA1, hw->dmarx);
   dma_enable_channel(DMA1, hw->dmarx);

   ResetDMA();

   usart_enable(usart);
}

/** Run the terminal */
void Terminal::Run()
{
   int numRcvd = dma_get_number_of_data(DMA1, hw->dmarx);
   int currentIdx = bufSize - numRcvd;

   if (0 == numRcvd)
      ResetDMA();

   while (lastIdx < currentIdx) //echo
      usart_send_blocking(usart, inBuf[lastIdx++]);

   if (currentIdx > 0)
   {
      if (inBuf[currentIdx - 1] == '\n' || inBuf[currentIdx - 1] == '\r')
      {
         inBuf[currentIdx] = 0;
         lastIdx = 0;
         char *space = (char*)my_strchr(inBuf, ' ');

         if (0 == *space) //No args after command, look for end of line
         {
            space = (char*)my_strchr(inBuf, '\n');
            args[0] = 0;
         }
         else //There are arguments, copy everything behind the space
         {
            my_strcpy(args, space + 1);
         }

         if (0 == *space) //No \n found? try \r
            space = (char*)my_strchr(inBuf, '\r');

         *space = 0;
         pCurCmd = NULL;

         if (my_strcmp(inBuf, "enableuart") == 0)
         {
            EnableUart(args);
            currentIdx = 0; //Prevent unknown command message
         }
         else if (my_strcmp(inBuf, "fastuart") == 0)
         {
            FastUart(args);
            currentIdx = 0;
         }
         else
         {
            pCurCmd = CmdLookup(inBuf);
         }

         ResetDMA();

         if (NULL != pCurCmd)
         {
            usart_wait_send_ready(usart);
            pCurCmd->CmdFunc(this, args);
         }
         else if (currentIdx > 1 && enabled)
         {
            Send("Unknown command sequence\r\n");
         }
      }
      else if (inBuf[0] == '!' && NULL != pCurCmd)
      {
         ResetDMA();
         lastIdx = 0;
         pCurCmd->CmdFunc(this, args);
      }
   }
}

void Terminal::SetNodeId(uint8_t id)
{
   char one[] = { '1', 0 };
   char buf[4];
   nodeId = id;

   if (nodeId != 1)
   {
      Send("Disabling terminal, type 'enableuart ");
      my_ltoa(buf, id, 10);
      Send(buf);
      Send("' to re-enable\r\n");
   }

   EnableUart(one);
}

/*
 * Revision 1 hardware can only use synchronous sending as the DMA channel is
 * occupied by the encoder timer (TIM3, channel 3).
 * All other hardware can use DMA for seamless sending of data. We use double
 * buffering, so while one buffer is sent by DMA we can prepare the other
 * buffer to go next.
*/
void Terminal::PutChar(char c)
{
   if (!txDmaEnabled)
   {
      usart_send_blocking(usart, c);
   }
   else if (c == '\n' || curIdx == (bufSize - 1))
   {
      outBuf[curBuf][curIdx] = c;

      while (!dma_get_interrupt_flag(DMA1, hw->dmatx, DMA_TCIF) && !firstSend);

      dma_disable_channel(DMA1, hw->dmatx);
      dma_set_number_of_data(DMA1, hw->dmatx, curIdx + 1);
      dma_set_memory_address(DMA1, hw->dmatx, (uint32_t)outBuf[curBuf]);
      dma_clear_interrupt_flags(DMA1, hw->dmatx, DMA_TCIF);
      dma_enable_channel(DMA1, hw->dmatx);

      curBuf = !curBuf; //switch buffers
      firstSend = false; //only needed once so we don't get stuck in the while loop above
      curIdx = 0;
   }
   else
   {
      outBuf[curBuf][curIdx] = c;
      curIdx++;
   }
}

bool Terminal::KeyPressed()
{
   return usart_get_flag(usart, USART_SR_RXNE);
}

void Terminal::FlushInput()
{
   usart_recv(usart);
}

void Terminal::DisableTxDMA()
{
   txDmaEnabled = false;
   dma_disable_channel(DMA1, hw->dmatx);
   usart_disable_tx_dma(usart);
}

void Terminal::ResetDMA()
{
   dma_disable_channel(DMA1, hw->dmarx);
   dma_set_memory_address(DMA1, hw->dmarx, (uint32_t)inBuf);
   dma_set_number_of_data(DMA1, hw->dmarx, bufSize);
   dma_enable_channel(DMA1, hw->dmarx);
}

void Terminal::EnableUart(char* arg)
{
   arg = my_trim(arg);
   int val = my_atoi(arg);

   if (val == nodeId)
   {
      enabled = true;
      gpio_set_mode(remap ? hw->port_re : hw->port, GPIO_MODE_OUTPUT_50_MHZ,
               GPIO_CNF_OUTPUT_ALTFN_PUSHPULL, remap ? hw->pin_re : hw->pin);
      Send("OK\r\n");
   }
   else
   {
      enabled = false;
      gpio_set_mode(remap ? hw->port_re : hw->port, GPIO_MODE_INPUT,
               GPIO_CNF_INPUT_FLOAT, remap ? hw->pin_re : hw->pin);
   }
}

void Terminal::FastUart(char *arg)
{
   arg = my_trim(arg);
   int baud = arg[0] == '0' ? USART_BAUDRATE : 921600;
   if (enabled)
   {
      Send("OK\r\n");
      Send("Baud rate now 921600\r\n");
   }
   usart_set_baudrate(usart, baud);
   usart_set_stopbits(usart, USART_STOPBITS_1);
}

const TERM_CMD* Terminal::CmdLookup(char *buf)
{
   const TERM_CMD *pCmd = termCmds;

   if (!enabled) return NULL;

   for (; NULL != pCmd->cmd; pCmd++)
   {
      if (0 == my_strcmp(buf, pCmd->cmd))
      {
         break;
      }
   }
   if (NULL == pCmd->cmd)
   {
      pCmd = NULL;
   }
   return pCmd;
}

void Terminal::Send(const char *str)
{
   for (;*str > 0; str++)
       usart_send_blocking(usart, *str);
}

//Backward compatibility for printf
extern "C" void putchar(int c)
{
   Terminal::defaultTerminal->PutChar(c);
}
