damienmaguire/Tesla-Model-3-Charger/Software/stm32-M3-PCS/src/param_save.cpp

/*
 * This file is part of the libopeninv project.
 *
 * Copyright (C) 2011 Johannes Huebner <dev@johanneshuebner.com>
 *
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
 * You should have received a copy of the GNU General Public License
 * along with this program.  If not, see <http://www.gnu.org/licenses/>.
 */

#include <libopencm3/stm32/flash.h>
#include <libopencm3/stm32/desig.h>
#include <libopencm3/stm32/crc.h>
#include "params.h"
#include "param_save.h"
#include "hwdefs.h"
#include "my_string.h"

#define NUM_PARAMS ((PARAM_BLKSIZE - 8) / sizeof(PARAM_ENTRY))
#define PARAM_WORDS (PARAM_BLKSIZE / 4)

typedef struct
{
   uint16_t key;
   uint8_t dummy;
   uint8_t flags;
   uint32_t value;
} PARAM_ENTRY;

typedef struct
{
   PARAM_ENTRY data[NUM_PARAMS];
   uint32_t crc;
   uint32_t padding;
} PARAM_PAGE;

static uint32_t GetFlashAddress()
{
   uint32_t flashSize = desig_get_flash_size();

   //Always save parameters to last flash page
   return FLASH_BASE + flashSize * 1024 - PARAM_BLKNUM * PARAM_BLKSIZE;
}

/**
* Save parameters to flash
*
* @return CRC of parameter flash page
*/
uint32_t parm_save()
{
   PARAM_PAGE parmPage;
   uint32_t idx;
   uint32_t paramAddress = GetFlashAddress();
   uint32_t check = 0xFFFFFFFF;
   uint32_t* baseAddress = (uint32_t*)paramAddress;

   for (int i = 0; i < PARAM_WORDS; i++, baseAddress++)
      check &= *baseAddress;

   crc_reset();
   memset32((int*)&parmPage, 0xFFFFFFFF, PARAM_WORDS);

   //Copy parameter values and keys to block structure
   for (idx = 0; Param::IsParam((Param::PARAM_NUM)idx) && idx < NUM_PARAMS; idx++)
   {
      const Param::Attributes *pAtr = Param::GetAttrib((Param::PARAM_NUM)idx);
      parmPage.data[idx].flags = (uint8_t)Param::GetFlag((Param::PARAM_NUM)idx);
      parmPage.data[idx].key = pAtr->id;
      parmPage.data[idx].value = Param::Get((Param::PARAM_NUM)idx);
   }

   parmPage.crc = crc_calculate_block(((uint32_t*)&parmPage), (2 * NUM_PARAMS));
   flash_unlock();

   if (check != 0xFFFFFFFF)
      flash_erase_page(paramAddress);

   for (idx = 0; idx < PARAM_WORDS; idx++)
   {
      uint32_t* pData = ((uint32_t*)&parmPage) + idx;
      flash_program_word(paramAddress + idx * sizeof(uint32_t), *pData);
   }
   flash_lock();
   return parmPage.crc;
}

/**
* Load parameters from flash
*
* @retval 0 Parameters loaded successfully
* @retval -1 CRC error, parameters not loaded
*/
int parm_load()
{
   uint32_t paramAddress = GetFlashAddress();
   PARAM_PAGE *parmPage = (PARAM_PAGE *)paramAddress;

   crc_reset();
   uint32_t crc = crc_calculate_block(((uint32_t*)parmPage), (2 * NUM_PARAMS));

   if (crc == parmPage->crc)
   {
      for (unsigned int idxPage = 0; idxPage < NUM_PARAMS; idxPage++)
      {
         Param::PARAM_NUM idx = Param::NumFromId(parmPage->data[idxPage].key);
         if (idx != Param::PARAM_INVALID && parmPage->data[idxPage].key > 0)
         {
            Param::SetFixed(idx, parmPage->data[idxPage].value);
            Param::SetFlagsRaw(idx, parmPage->data[idxPage].flags);
         }
      }
      return 0;
   }

   return -1;
}
