damienmaguire/Tesla-Model-3-Charger/Software/stm32-M3-PCS/include/errormessage_prj.h

#ifndef ERRORMESSAGE_PRJ_H_INCLUDED
#define ERRORMESSAGE_PRJ_H_INCLUDED

#define ERROR_BUF_SIZE 4

#define ERROR_MESSAGE_LIST \
   ERROR_MESSAGE_ENTRY(CHARGERFAULT, ERROR_STOP) \
   ERROR_MESSAGE_ENTRY(EXTCAN, ERROR_STOP) \

#endif // ERRORMESSAGE_PRJ_H_INCLUDED
