damienmaguire/Tesla-Model-3-Charger/(commit log)

2021-12-01 Add full V6 SAM3 Firmware
    Adding fully functional V6 firmware to run pcs using original SAM3x8E Arduino Due hardware.
2022-05-28 Add V3 Pinout and PDF Schematic and board layout
2022-08-27 Add v4 PCS code
    Adding the simple version of sw that runs on the Arduino Due for bench testing PCS
2022-08-27 Add fail log from video
    [2020_pcs_failV4.csv]
2022-08-28 Failure log day 2
    [2020_pcs_failV4_day2.csv]
2022-08-29 Add successful pcs run log
    Log of a quick bench run to 500w then 250w then 0w then off.
    [2020_pcs_success_day2_500w.csv]
2022-08-30 Add CAN spreadsheet
    [PCS_CAN_Listing.ods]
2022-09-02 Add V1 STM32 Firmware
2022-11-15 fix drive mode bug
    [main.cpp]
2022-11-24 First release and fixes
    -First release
    -Fix BMS hvdc voltage reading
    -Implement charge power ramping
    -Implement DCDC precharge hold off timer
    -Implement charge power ramp off time delay
    -Drive mode for DCDC trigger on IN2
    [PCSCan.cpp, PCSCan.h, main.cpp, param_prj.h]
