damienmaguire/Tesla-Model-3-Charger/(notices)

Notices in the files:
Software/stm32-M3-PCS/src/printf.cpp:
This program is free software; you can redistribute it and/or modify
it under the terms of the GNU Lesser General Public License as published by
the Free Software Foundation; either version 2 of the License, or
(at your option) any later version.
Software/stm32-M3-PCS/src/crc8.cpp:
it under the terms of the GNU General Public License as published by
the Free Software Foundation, either version 3 of the License, or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
